purdue-arc/piano-hand-v2-stm32/production/bom.xlsx

Comment | Designator | Footprint | LCSC Part #
22u | C1 | 0805 | 1276-1274-2-ND
100 μF | C2 | 0805 | 3372-0805N101J201ADTR-ND
0.1uF | C3 | 0805 | 3372-0805B104K500BDTR-ND
0.47uF | C4 | 0805 | 3372-0805B474K500CCTR-ND
470nF | C5 | 0805 | 3372-0805B474K500CCTR-ND
2.2uF | C6 | 0805 | 3372-0805B225K250CCTR-ND
1uF | C7 | 0805 | 3372-0805N101J201ADTR-ND
Barrel_Jack | J1 | BarrelJack_SwitchcraftConxall_RAPC10U_Horizontal | SC2072-ND
Motor_Servo | M1, M2, M3, M4, M5, M6 | PinHeader_1x03_P2.54mm_Vertical
Stepper_Motor | M7 | PinHeader_1x04_P2.54mm_Vertical
Microphone | MK1 | POM-2244P-C3310-2-R | 668-1415-ND
150k | R1 | 0805 | YAG3409TR-ND
100k | R2 | 0805 | 311-100KARTR-ND
ESP32-DEVKITC-32UE | U1 | MODULE_DEVKIT_V1_ESP32-WROOM-32
LM2596 | U2 | LM2596
A4988_Stepper_Motor_Driver | U3 | Pololu_Breakout-16_15.2x20.3mm
~ | U4 | PinHeader_1x04_P2.54mm_Vertical | `
MAX9814ETD_T | U5 | SON40P300X300X80-15N | MAX9814ETD+TTR-ND
1k | R3,R4, R5,R6,R7,R8 | 0805 | C702831
