purdue-arc/piano-hand-v2-stm32/pcb-design/production/Hand_System_Rev_1.csv

Reference | Qty | Value | DNP | Exclude from BOM | Exclude from Board | Footprint | Datasheet
C1 | 1 | 22uF |  |  |  | Capacitor_SMD:C_0805_2012Metric | ~
C2 | 1 | 100 uF |  |  |  | Capacitor_SMD:C_0805_2012Metric | ~
C3,C4 | 2 | 10uF |  |  |  | Capacitor_SMD:C_0805_2012Metric | ~
H1,H2,H3,H4 | 4 | MountingHole |  | Excluded from BOM |  | MountingHole:MountingHole_4.3mm_M4 | ~
J1 | 1 | Barrel_Jack |  |  |  | Connector_BarrelJack:BarrelJack_SwitchcraftConxall_RAPC10U_Horizontal | https://www.sameskydevices.com/product/resource/pj-007.pdf
M1,M2,M3,M4,M5,M6,M8,M9,M10,M11 | 10 | Motor_Servo |  |  |  | Connector_PinHeader_2.54mm:PinHeader_1x03_P2.54mm_Vertical | ~
M7 | 1 | Stepper_Motor |  |  |  | Connector_PinHeader_2.54mm:PinHeader_1x04_P2.54mm_Vertical | ~
Q1,Q2 | 2 | IRF6623 |  |  |  | Package_DirectFET:DirectFET_ST | https://www.infineon.com/dgdl/irf6623pbf.pdf?fileId=5546d462533600a4015355e8aa811a2d
R1,R14,R28,R35 | 4 | 10k |  |  |  | Resistor_SMD:R_0805_2012Metric | ~
R2,R13,R15,R16 | 4 | 1k |  |  |  | Resistor_SMD:R_0805_2012Metric | ~
R3,R4,R5,R6,R7,R8,R9,R10,R11,R12 | 10 | 1K |  |  |  | Resistor_SMD:R_0805_2012Metric | ~
R23,R24,R25,R26,R27,R36,R37,R38,R39,R40 | 10 | 220 |  |  |  | Resistor_SMD:R_0805_2012Metric | ~
U1 | 1 | ESP32-DEVKITC-32UE |  |  |  | DEVKIT_V1_ESP32-WROOM-32:MODULE_DEVKIT_V1_ESP32-WROOM-32
U2,U5,U6 | 3 | LM2596 |  |  |  | PCB_Components:LM2596 | https://www.amazon.com/Seloky-Converter-Adjustable-Electronic-Stabilizer/dp/B0DBVYP91F
U3 | 1 | A4988_Stepper_Motor_Driver |  |  |  | Module:Pololu_Breakout-16_15.2x20.3mm | https://www.pololu.com/product/2980/pictures
U4 | 1 | ~ |  |  |  | Connector_PinHeader_2.54mm:PinHeader_1x04_P2.54mm_Vertical
U7,U8 | 2 | PCA9685PW |  |  |  | Package_SO:TSSOP-28_4.4x9.7mm_P0.65mm | http://www.nxp.com/docs/en/data-sheet/PCA9685.pdf
