purdue-arc/piano-hand-v2-stm32/555timer/555timer.kicad_sch

## KiCad design 555timer/555timer.kicad_sch (2026-11-13)

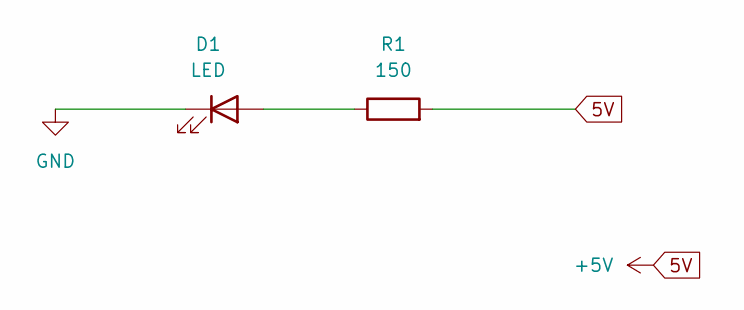
[picture p1: schematic 555timer.kicad_sch]

Parts:
D1: LED; LED_D1.8mm_W1.8mm_H2.4mm_Horizontal_O3.81mm_Z8.2mm
R1: 150; R_Axial_DIN0207_L6.3mm_D2.5mm_P10.16mm_Horizontal

Connections:
+5V: R1.2
GND: D1.1 (K)
unnamed: D1.2 (A), R1.1
