purdue-arc/piano-hand-v2-stm32/(commit log)

2026-10-22 STM32 migration
2026-11-08 Revise project status and team roles in README
    Updated the status section in the README to reflect current project phases and team roles.
2026-11-13 Create README.md with project details and instructions
    Added comprehensive README.md for project overview, quick-start guide, repository structure, hardware overview, current status, development subtopics, and documentation index.
